kurrosetra/DisplayBangla/Documents/InternGerbong.jpeg

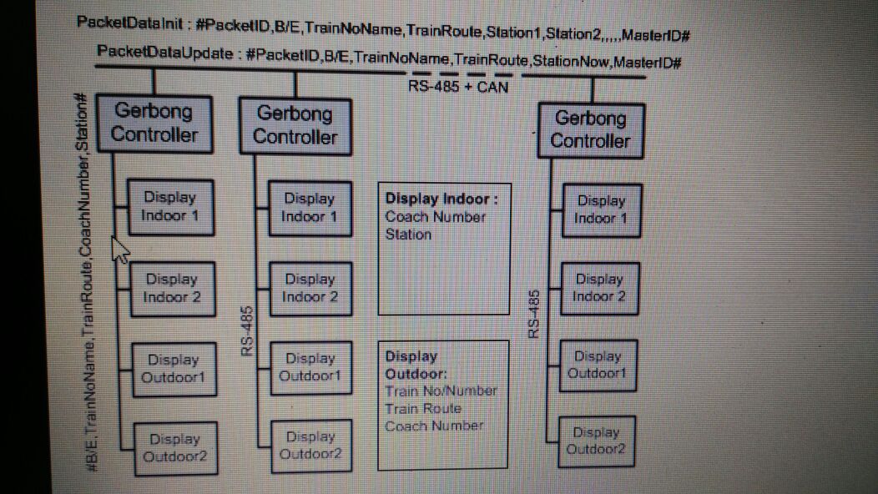
Documents/InternGerbong.jpeg
