kurrosetra/DisplayBangla/Documents/BlokGerbongController.jpeg

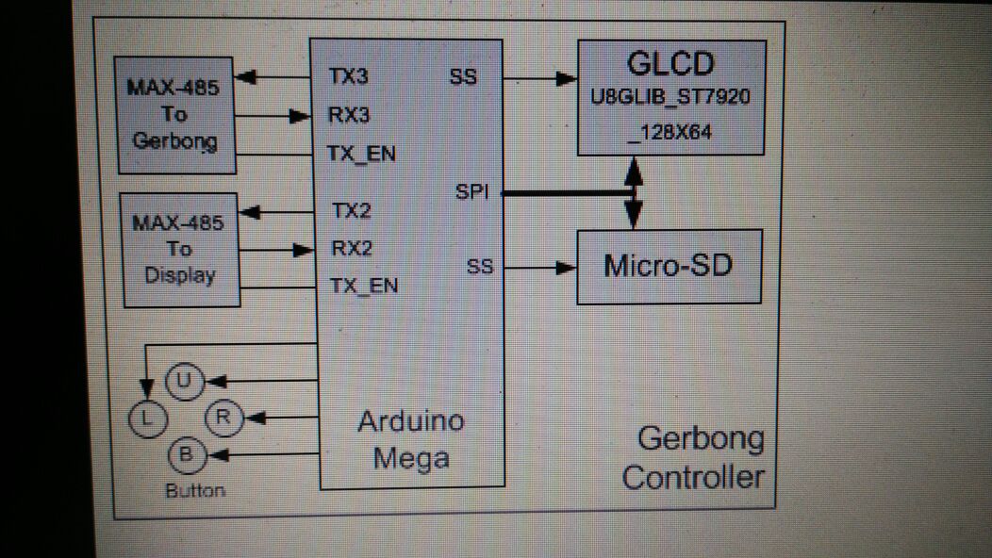
Documents/BlokGerbongController.jpeg
