kurrosetra/DisplayBangla/README.md

# DisplayBangla
INKA - Display for Bangladesh's train
