kurrosetra/DisplayBangla/Documents/Menu.jpeg

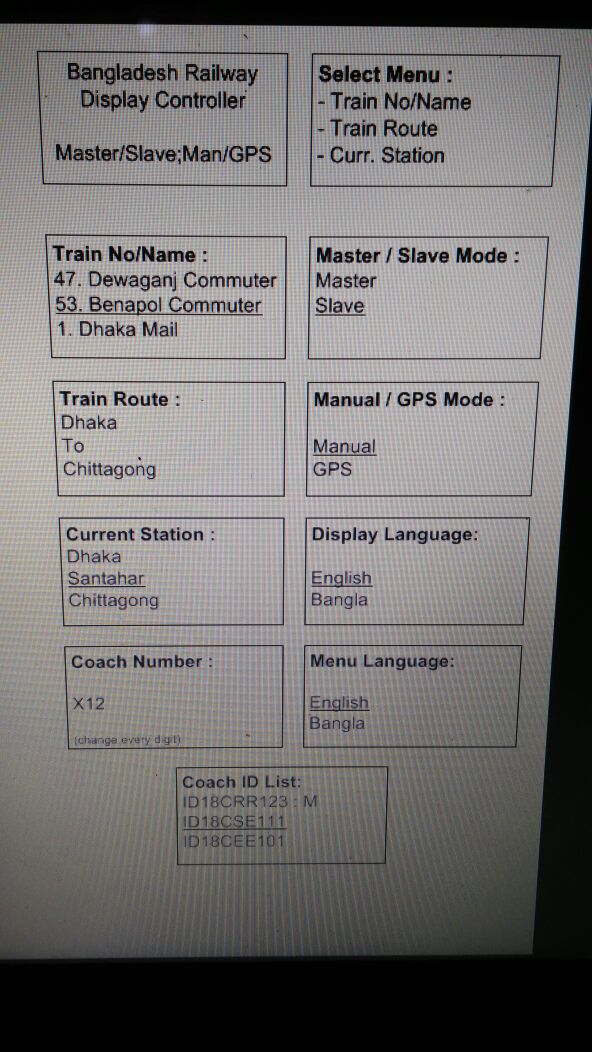
Documents/Menu.jpeg
