kurrosetra/DisplayBangla/Boards/rgbMatrix.brd

## EAGLE design Boards/rgbMatrix.brd (2018-09-11)

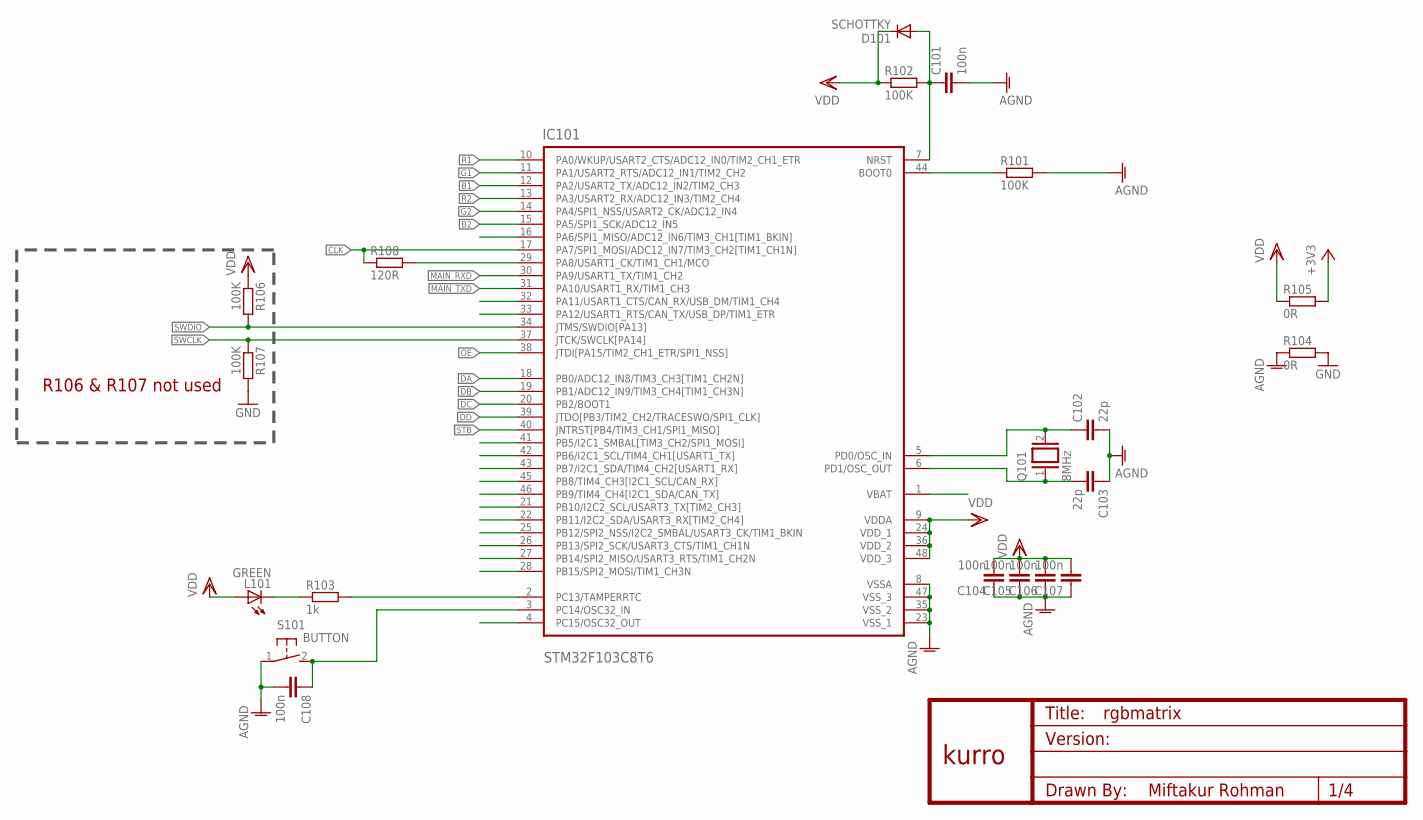
[picture p4: schematic rgbMatrix.sch, sheet 1, CONTROLLER]

Parts:
C101, C104, C105, C106, C107, C108: 100n; C0603
C102, C103: 22p; C0603
D101: SCHOTTKY; MICROMELF-W
IC101: STM32F103C8T6; QFP50P900X900X160-48N
L101: GREEN; LED3MM
Q101: 8MHz; QS
R101, R102, R106, R107: 100K; R0603
R103: 1k; R0603
R104, R105: 0R; R0603
R108: 120R; R0603
S101: BUTTON; B3F-01XXX
U$1: KURRO_FOOTPRINT; KURRO-LOGO

Connections:
+3V3: R105.2; also elsewhere on the board
AGND: C101.2, C102.2, C103.1, C104.1, C105.1, C106.1, C107.1, C108.2, IC101.8 (VSSA), IC101.23 (VSS_1), IC101.35 (VSS_2), IC101.47 (VSS_3), R101.2, R104.1, S101.1
B1: IC101.12 (PA2/USART2_TX/ADC12_IN2/TIM2_CH3); also elsewhere on the board
B2: IC101.15 (PA5/SPI1_SCK/ADC12_IN5); also elsewhere on the board
BOOT0: IC101.44 (BOOT0), R101.1
CLK: IC101.17 (PA7/SPI1_MOSI/ADC12_IN7/TIM3_CH2[TIM1_C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), R108.1; also elsewhere on the board
DA: IC101.18 (PB0/ADC12_IN8/TIM3_CH3[TIM1_CH2N]); also elsewhere on the board
DB: IC101.19 (PB1/ADC12_IN9/TIM3_CH4[TIM1_CH3N]); also elsewhere on the board
DC: IC101.20 (PB2/BOOT1); also elsewhere on the board
DD: IC101.39 (JTDO[PB3/TIM2_CH2/TRACESWO/SPI1_CLK]); also elsewhere on the board
G1: IC101.11 (PA1/USART2_RTS/ADC12_IN1/TIM2_CH2); also elsewhere on the board
G2: IC101.14 (PA4/SPI1_NSS/USART2_CK/ADC12_IN4); also elsewhere on the board
GND: R104.2, R107.2; also elsewhere on the board
LED1_BUILTIN: IC101.2 (PC13/TAMPERRTC), R103.2
MAIN_RXD: IC101.30 (PA9/USART1_TX/TIM1_CH2)
MAIN_TXD: IC101.31 (PA10/USART1_RX/TIM1_CH3); also elsewhere on the board
unnamed: IC101.29 (PA8/USART1_CK/TIM1_CH1/MCO), R108.2
unnamed: C103.2, IC101.6 (PD1/OSC_OUT), Q101.1
unnamed: C102.1, IC101.5 (PD0/OSC_IN), Q101.2
unnamed: L101.K (C), R103.1
unnamed: C108.1, IC101.3 (PC14/OSC32_IN), S101.2 (S)
OE: IC101.38 (JTDI[PA15/TIM2_CH1_ETR/SPI1_NSS]); also elsewhere on the board
R1: IC101.10 (PA0/WKUP/USART2_CTS/ADC12_IN0/TIM2_CH1_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); also elsewhere on the board
R2: IC101.13 (PA3/USART2_RX/ADC12_IN3/TIM2_CH4); also elsewhere on the board
RST: C101.1, D101.A, IC101.7 (NRST), R102.2
STB: IC101.40 (JNTRST[PB4/TIM3_CH1/SPI1_MISO]); also elsewhere on the board
SWCLK: IC101.37 (JTCK/SWCLK[PA14]), R107.1; also elsewhere on the board
SWDIO: IC101.34 (JTMS/SWDIO[PA13]), R106.2; also elsewhere on the board
VDD: C104.2, C105.2, C106.2, C107.2, D101.C, IC101.9 (VDDA), IC101.24 (VDD_1), IC101.36 (VDD_2), IC101.48 (VDD_3), L101.A, R102.1, R105.1, R106.1

Notes on the sheet:
R106 & R107 not used

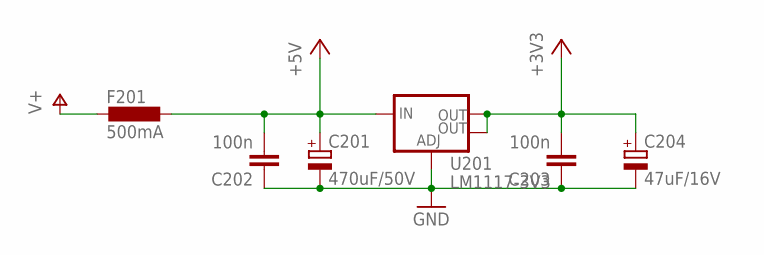
[picture p5: schematic rgbMatrix.sch, sheet 2, POWER]

Parts:
C201: 470uF/50V; E5-10,5
C202, C203: 100n; C0603
C204: 47uF/16V; E2-5
F201: 500mA; L1812
U201: LM1117-3V3; SOT223

Connections:
+3V3: C203.2, C204.+, U201.2 (OUT), U201.4 (OUT); also elsewhere on the board
+5V: C201.+, C202.2, F201.1, U201.3 (IN)
GND: C201.-, C202.1, C203.1, C204.-, U201.1 (ADJ); also elsewhere on the board
V+: F201.2; also elsewhere on the board

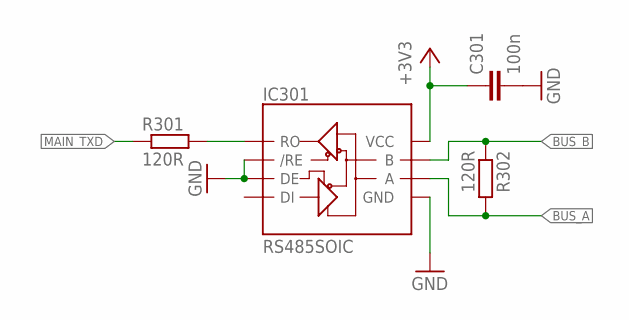
[picture p6: schematic rgbMatrix.sch, sheet 3, COMM]

Parts:
C301: 100n; C0603
IC301: RS485SOIC; SO08
R301, R302: 120R; R0603

Connections:
+3V3: C301.1, IC301.8 (VCC); also elsewhere on the board
BUS_A: IC301.6 (A), R302.2; also elsewhere on the board
BUS_B: IC301.7 (B), R302.1; also elsewhere on the board
GND: C301.2, IC301.2 (/RE), IC301.3 (DE), IC301.5 (GND); also elsewhere on the board
MAIN_TXD: R301.1; also elsewhere on the board
unnamed: IC301.1 (RO), R301.2

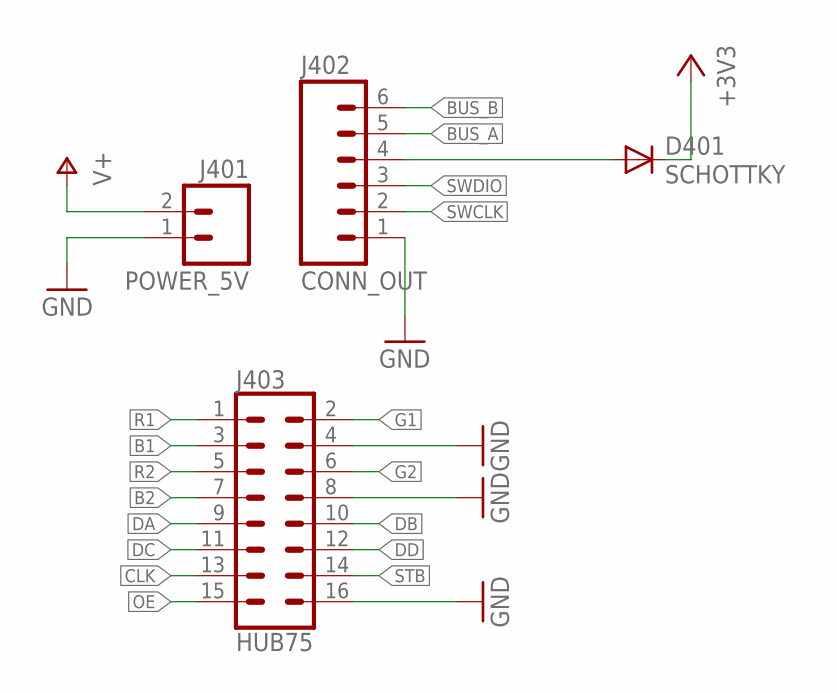
[picture p7: schematic rgbMatrix.sch, sheet 4, CONNECTOR]

Parts:
D401: SCHOTTKY; MICROMELF-W
J401: POWER_5V; XH-2-RA
J402: CONN_OUT; XH-6-RA
J403: HUB75; 2X08-LOCK

Connections:
+3V3: D401.C; also elsewhere on the board
B1: J403.3; also elsewhere on the board
B2: J403.7; also elsewhere on the board
BUS_A: J402.5; also elsewhere on the board
BUS_B: J402.6; also elsewhere on the board
CLK: J403.13; also elsewhere on the board
DA: J403.9; also elsewhere on the board
DB: J403.10; also elsewhere on the board
DC: J403.11; also elsewhere on the board
DD: J403.12; also elsewhere on the board
G1: J403.2; also elsewhere on the board
G2: J403.6; also elsewhere on the board
GND: J401.1, J402.1, J403.4, J403.8, J403.16; also elsewhere on the board
unnamed: D401.A, J402.4
OE: J403.15; also elsewhere on the board
R1: J403.1; also elsewhere on the board
R2: J403.5; also elsewhere on the board
STB: J403.14; also elsewhere on the board
SWCLK: J402.2; also elsewhere on the board
SWDIO: J402.3; also elsewhere on the board
V+: J401.2; also elsewhere on the board

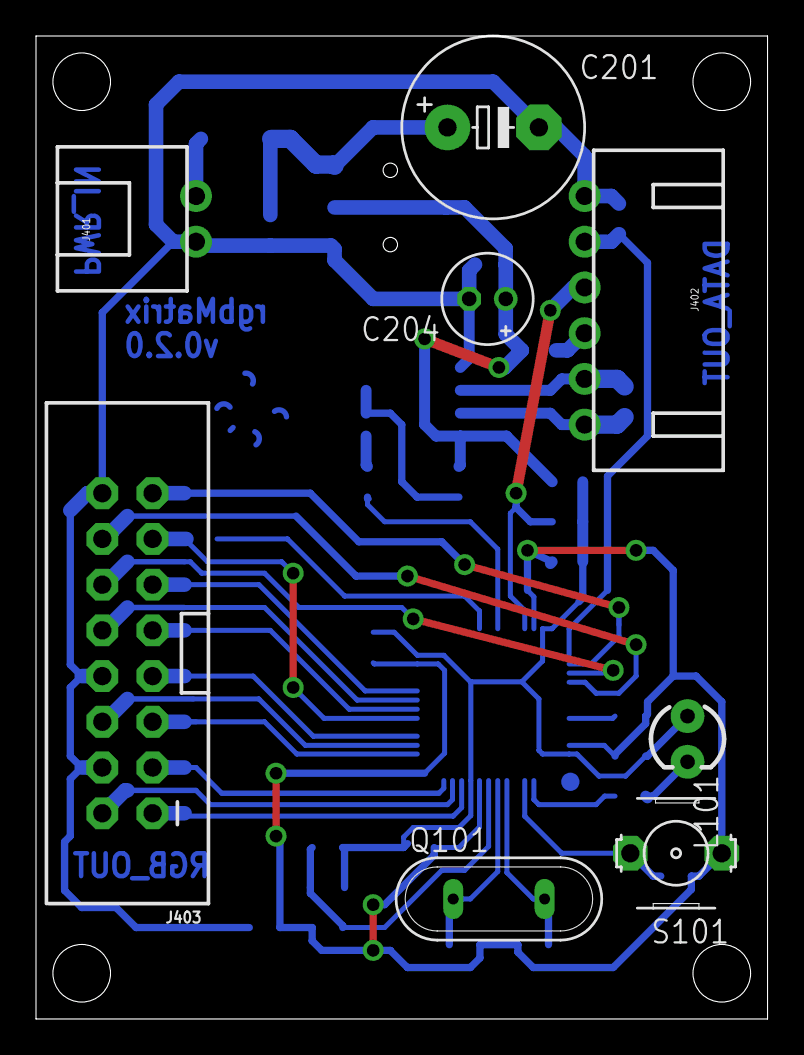
[picture p8: board rgbMatrix.brd from above]

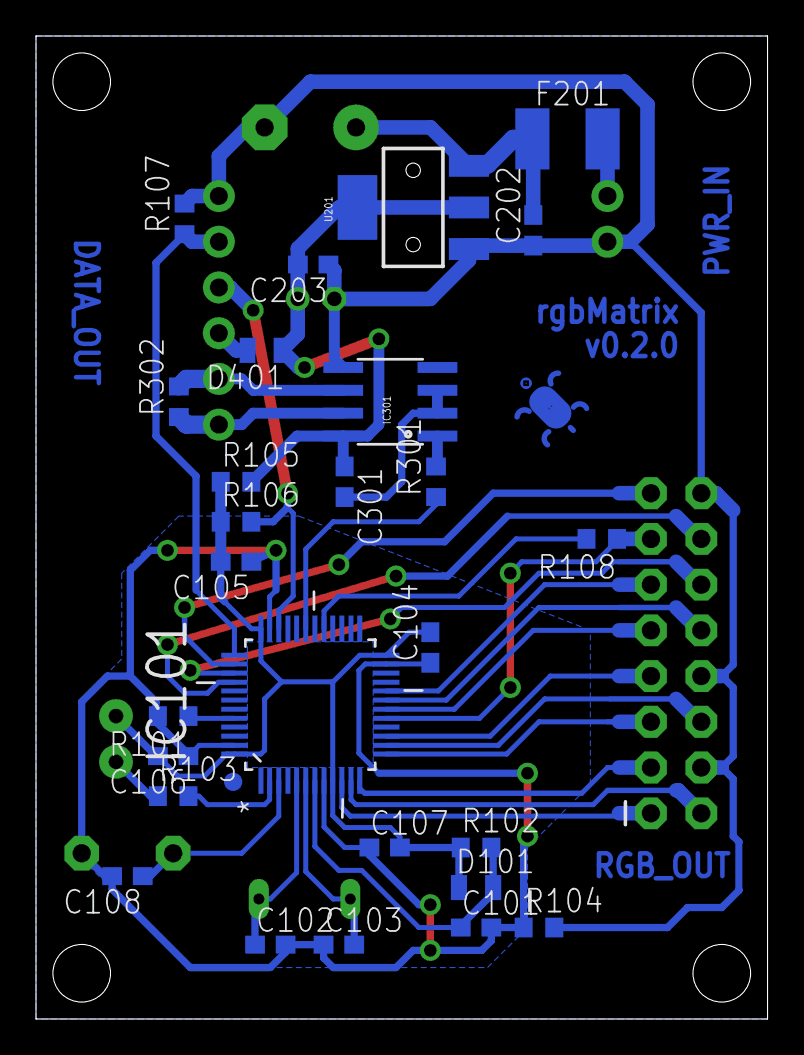
[picture p9: board rgbMatrix.brd from below]

Board: 2 copper layers, 40.6 x 54.6 mm, 36 parts (27 on the bottom side), 34 nets.
