kurrosetra/DisplayBangla/Boards/v2560.brd

## EAGLE design Boards/v2560.brd (2018-08-14)

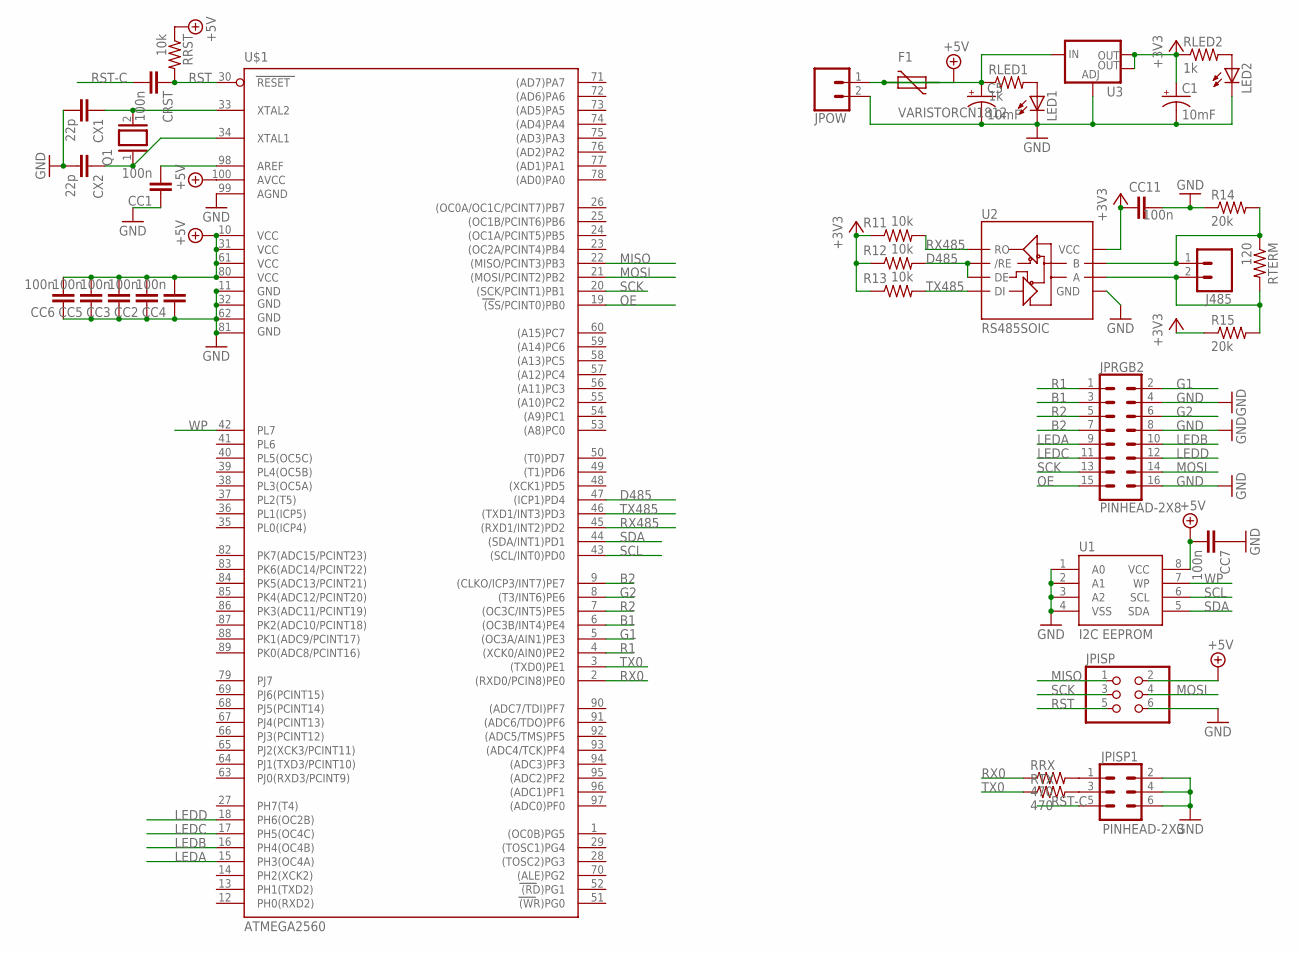
[picture p10: schematic v2560.sch]

Parts:
C1, C5: 10mF; CPOL-RADIAL-5MM-10MM
CC1, CC2, CC3, CC4, CC5, CC6, CC7, CC11: 100n; C0805
CRST: 100n; C0805
CX1, CX2: 22p; C0805
F1: VARISTORCN1812; CT/CN1812
J485: CONN_025MM; SCREWTERMINAL-5MM-2
JPISP: PINHD-2X3; 2X03
JPISP1: PINHEAD-2X3; 2X03-LOCK
JPOW: CONN_025MM; SCREWTERMINAL-5MM-2
JPRGB2: PINHEAD-2X8; 2X08-LOCK
LED1, LED2: LED3MM
Q1: XTAL/S; QS
R11, R12, R13: 10k; R0805
R14, R15: 20k; RES-0.3
RLED1, RLED2: 1k; R0805
RRST: 10k; R0805
RRX: 470; R0805
RTERM: 120; R0805
RTX: 470; R0805
U1: I2C EEPROM; SO08-EIAJ
U2: RS485SOIC; SO08
U3: V_REG_LM1117SOT223; SOT223
U$1: ATMEGA2560; TQFP100

Connections:
+3V3: C1.+, CC11.2, R11.1, R12.1, R13.1, R15.1, RLED2.1, U2.8 (VCC), U3.2 (OUT), U3.4 (OUT)
+5V: C5.+, CC2.2, CC3.2, CC4.2, CC5.2, CC6.2, CC7.2, F1.2, JPISP.2, RLED1.1, RRST.1, U1.8 (VCC), U3.3 (IN), U$1.10 (VCC), U$1.31 (VCC1), U$1.61 (VCC2), U$1.80 (VCC3), U$1.100 (AVCC)
AREF: CC1.2, U$1.98 (AREF)
B1: JPRGB2.3, U$1.6 ((OC3B/INT4)PE4)
B2: JPRGB2.7, U$1.9 ((CLKO/ICP3/INT7)PE7)
D485: R12.2, U2.2 (/RE), U2.3 (DE), U$1.47 ((ICP1)PD4)
G1: JPRGB2.2, U$1.5 ((OC3A/AIN1)PE3)
G2: JPRGB2.6, U$1.8 ((T3/INT6)PE6)
GND: C1.-, C5.-, CC1.1, CC2.1, CC3.1, CC4.1, CC5.1, CC6.1, CC7.1, CC11.1, CX1.2, CX2.2, JPISP.6, JPISP1.2, JPISP1.4, JPISP1.6, JPOW.2, JPRGB2.4, JPRGB2.8, JPRGB2.16, LED1.K (C), LED2.K (C), R14.1, U1.1 (A0), U1.2 (A1), U1.3 (A2), U1.4 (VSS), U2.5 (GND), U3.1 (ADJ), U$1.11 (GND), U$1.32 (GND1), U$1.62 (GND2), U$1.81 (GND3), U$1.99 (AGND)
LEDA: JPRGB2.9, U$1.15 (PH3(OC4A))
LEDB: JPRGB2.10, U$1.16 (PH4(OC4B))
LEDC: JPRGB2.11, U$1.17 (PH5(OC4C))
LEDD: JPRGB2.12, U$1.18 (PH6(OC2B))
MISO: JPISP.1, U$1.22 ((MISO/PCINT3)PB3)
MOSI: JPISP.4, JPRGB2.14, U$1.21 ((MOSI/PCINT2)PB2)
unnamed: J485.2, R15.2, RTERM.2, U2.6 (A)
unnamed: CX1.1, Q1.2, U$1.33 (XTAL2)
unnamed: CX2.1, Q1.1, U$1.34 (XTAL1)
unnamed: LED1.A, RLED1.2
unnamed: LED2.A, RLED2.2
unnamed: J485.1, R14.2, RTERM.1, U2.7 (B)
unnamed: F1.1, JPOW.1
unnamed: JPISP1.3, RTX.2
unnamed: JPISP1.1, RRX.2
OE: JPRGB2.15, U$1.19 ((SS/PCINT0)PB0)
R1: JPRGB2.1, U$1.4 ((XCK0/AIN0)PE2)
R2: JPRGB2.5, U$1.7 ((OC3C/INT5)PE5)
RST: CRST.1, JPISP.5, RRST.2, U$1.30 (RESET)
RST-C: CRST.2, JPISP1.5
RX0: RRX.1, U$1.2 ((RXD0/PCIN8)PE0)
RX485: R11.2, U2.1 (RO), U$1.45 ((RXD1/INT2)PD2)
SCK: JPISP.3, JPRGB2.13, U$1.20 ((SCK/PCINT1)PB1)
SCL: U1.6 (SCL), U$1.43 ((SCL/INT0)PD0)
SDA: U1.5 (SDA), U$1.44 ((SDA/INT1)PD1)
TX0: RTX.1, U$1.3 ((TXD0)PE1)
TX485: R13.2, U2.4 (DI), U$1.46 ((TXD1/INT3)PD3)
WP: U1.7 (WP), U$1.42 (PL7)

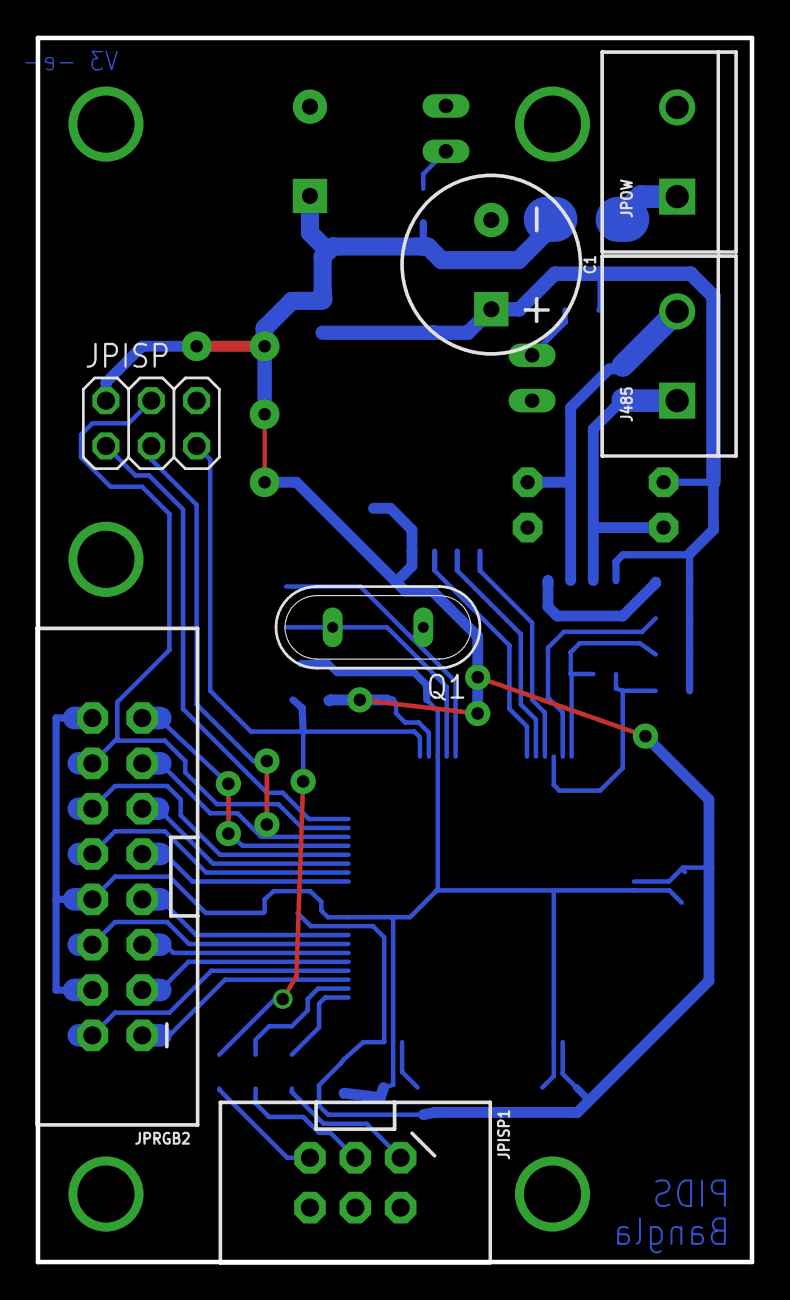
[picture p11: board v2560.brd from above]

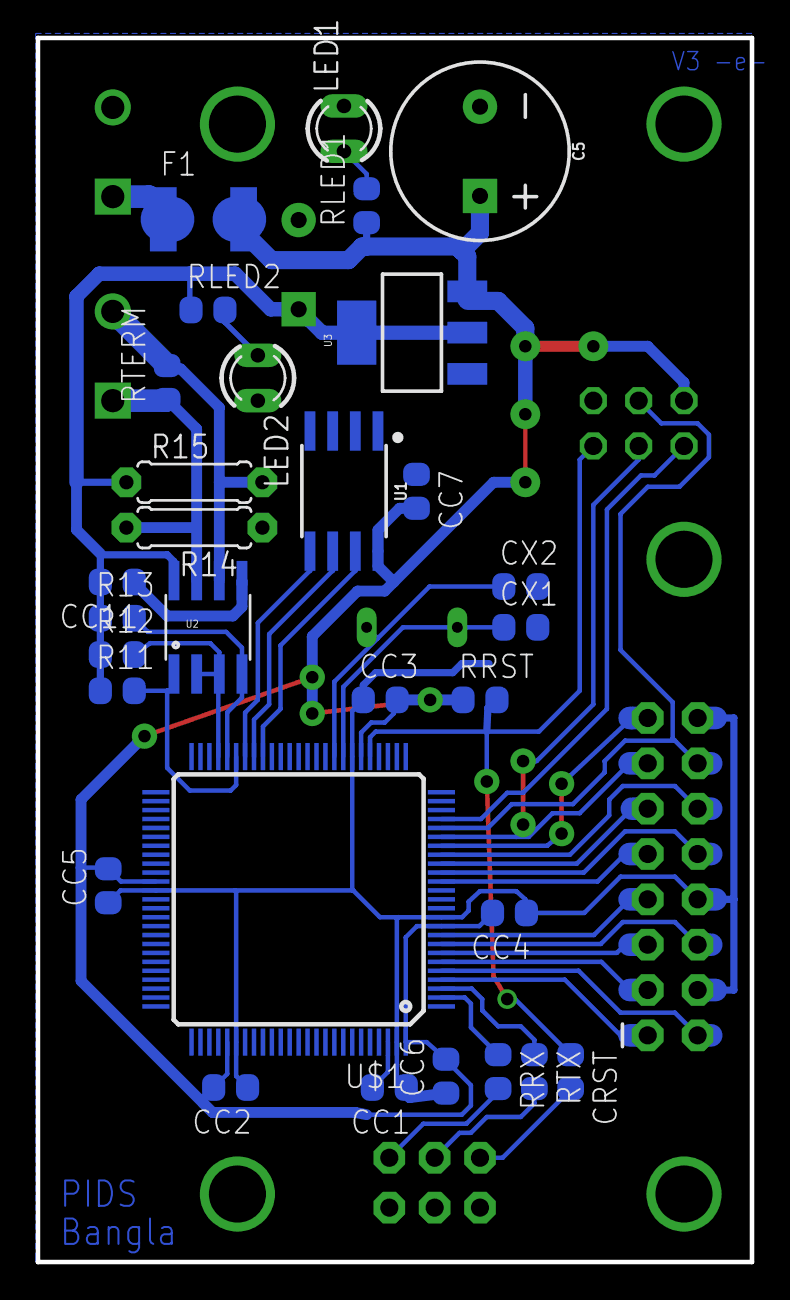
[picture p12: board v2560.brd from below]

Board: 2 copper layers, 40.0 x 68.6 mm, 37 parts (30 on the bottom side), 37 nets.
