kurrosetra/DisplayBangla/Boards/kontroller2.brd

## EAGLE design Boards/kontroller2.brd (2018-07-13)

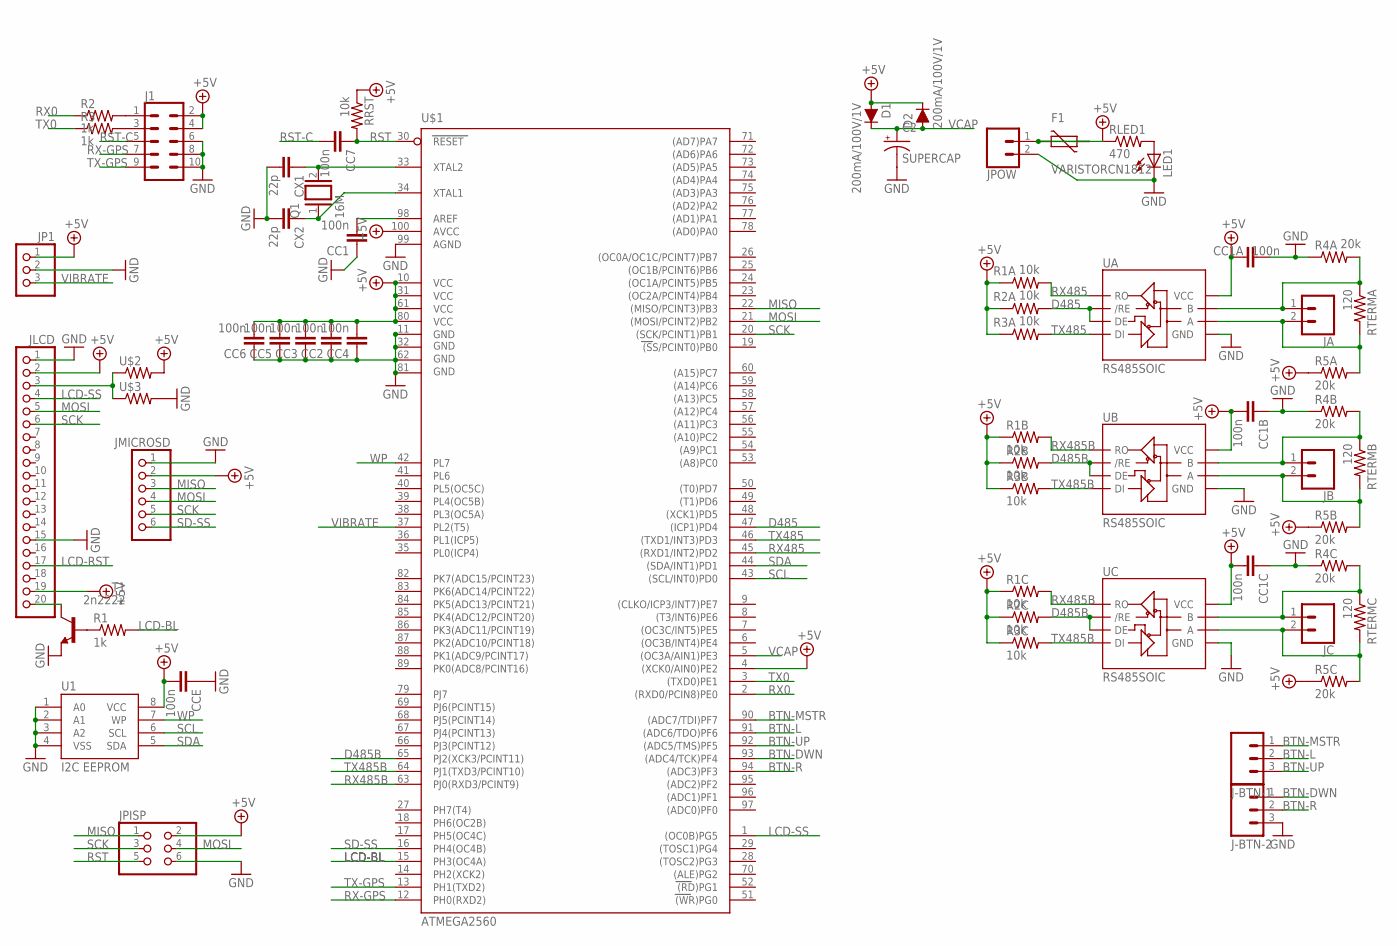
[picture p13: schematic kontroller2.sch]

Parts:
C2: SUPERCAP; SUPERCAP-25MM
CC1, CC1A, CC1B, CC1C, CC2, CC3, CC4, CC5, CC6, CC7: 100n; C0805
CCE: 100n; C0805
CX1, CX2: 22p; C0805
D1, D2: 200mA/100V/1V; DIODE-1N4148
F1: VARISTORCN1812; CT/CN1812
J1: CONN_05X2SHD_LOCK; 2X5-SHROUDED_LOCK
J-BTN-1, J-BTN-2: M03-SCREW-5MM; SCREWTERMINAL-5MM-3
JA: CONN_025MM; SCREWTERMINAL-5MM-2
JB: CONN_025MM; SCREWTERMINAL-5MM-2
JC: CONN_025MM; SCREWTERMINAL-5MM-2
JLCD: PINHD-1X20; 1X20
JMICROSD: PINHD-1X6; 1X06
JP1: PINHD-1X3; 1X03
JPISP: PINHD-2X3; 2X03
JPOW: CONN_025MM; SCREWTERMINAL-5MM-2
LED1: LED3MM
Q1: 16M; QS
R1, R2, R3: 1k; R0805
R1A, R1B, R1C, R2A, R2B, R2C, R3A, R3B, R3C: 10k; R0805
R4A, R4B, R4C, R5A, R5B, R5C: 20k; RES-0.3
RLED1: 470; R0805
RRST: 10k; R0805
RTERMA: 120; R0805
RTERMB: 120; R0805
RTERMC: 120; R0805
T1: 2n2222; TO92-EBC
U1: I2C EEPROM; SO08-EIAJ
U$1: ATMEGA2560; TQFP100
U$2, U$3: RES_R0805; R0805
UA: RS485SOIC; SO08
UB: RS485SOIC; SO08
UC: RS485SOIC; SO08

Connections:
+5V: CC1A.2, CC1B.2, CC1C.2, CC2.2, CC3.2, CC4.2, CC5.2, CC6.2, CCE.2, D1.A, D2.C, F1.2, J1.2, J1.4, JLCD.2, JLCD.19, JMICROSD.2, JP1.1, JPISP.2, R1A.1, R1B.1, R1C.1, R2A.1, R2B.1, R2C.1, R3A.1, R3B.1, R3C.1, R5A.1, R5B.1, R5C.1, RLED1.1, RRST.1, U1.8 (VCC), U$1.4 ((XCK0/AIN0)PE2), U$1.10 (VCC), U$1.31 (VCC1), U$1.61 (VCC2), U$1.80 (VCC3), U$1.100 (AVCC), U$2.2, UA.8 (VCC), UB.8 (VCC), UC.8 (VCC)
AREF: CC1.2, U$1.98 (AREF)
BTN-DWN: J-BTN-2.1, U$1.93 ((ADC4/TCK)PF4)
BTN-L: J-BTN-1.2, U$1.91 ((ADC6/TDO)PF6)
BTN-MSTR: J-BTN-1.1, U$1.90 ((ADC7/TDI)PF7)
BTN-R: J-BTN-2.2, U$1.94 ((ADC3)PF3)
BTN-UP: J-BTN-1.3, U$1.92 ((ADC5/TMS)PF5)
D485: R2A.2, U$1.47 ((ICP1)PD4), UA.2 (/RE), UA.3 (DE)
D485B: R2B.2, R2C.2, U$1.65 (PJ2(XCK3/PCINT11)), UB.2 (/RE), UB.3 (DE), UC.2 (/RE), UC.3 (DE)
GND: C2.-, CC1.1, CC1A.1, CC1B.1, CC1C.1, CC2.1, CC3.1, CC4.1, CC5.1, CC6.1, CCE.1, CX1.2, CX2.2, J1.6, J1.8, J1.10, J-BTN-2.3, JLCD.1, JLCD.15, JMICROSD.1, JP1.2, JPISP.6, JPOW.2, LED1.K (C), R4A.1, R4B.1, R4C.1, T1.E, U1.1 (A0), U1.2 (A1), U1.3 (A2), U1.4 (VSS), U$1.11 (GND), U$1.32 (GND1), U$1.62 (GND2), U$1.81 (GND3), U$1.99 (AGND), U$3.2, UA.5 (GND), UB.5 (GND), UC.5 (GND)
LCD-BL: R1.2, U$1.15 (PH3(OC4A))
LCD-RST: JLCD.17
LCD-SS: JLCD.4, U$1.1 ((OC0B)PG5)
MISO: JMICROSD.3, JPISP.1, U$1.22 ((MISO/PCINT3)PB3)
MOSI: JLCD.5, JMICROSD.4, JPISP.4, U$1.21 ((MOSI/PCINT2)PB2)
unnamed: JA.2, R5A.2, RTERMA.2, UA.6 (A)
unnamed: JC.1, R4C.2, RTERMC.1, UC.7 (B)
unnamed: JB.1, R4B.2, RTERMB.1, UB.7 (B)
unnamed: JB.2, R5B.2, RTERMB.2, UB.6 (A)
unnamed: CX1.1, Q1.2, U$1.33 (XTAL2)
unnamed: CX2.1, Q1.1, U$1.34 (XTAL1)
unnamed: LED1.A, RLED1.2
unnamed: JLCD.3, U$2.1, U$3.1
unnamed: JLCD.20, T1.C
unnamed: R1.1, T1.B
unnamed: J1.1, R2.2
unnamed: J1.3, R3.2
unnamed: F1.1, JPOW.1
unnamed: JC.2, R5C.2, RTERMC.2, UC.6 (A)
unnamed: JA.1, R4A.2, RTERMA.1, UA.7 (B)
RST: CC7.1, JPISP.5, RRST.2, U$1.30 (RESET)
RST-C: CC7.2, J1.5
RX0: R2.1, U$1.2 ((RXD0/PCIN8)PE0)
RX485: R1A.2, U$1.45 ((RXD1/INT2)PD2), UA.1 (RO)
RX485B: R1B.2, R1C.2, U$1.63 (PJ0(RXD3/PCINT9)), UB.1 (RO), UC.1 (RO)
RX-GPS: J1.7, U$1.12 (PH0(RXD2))
SCK: JLCD.6, JMICROSD.5, JPISP.3, U$1.20 ((SCK/PCINT1)PB1)
SCL: U1.6 (SCL), U$1.43 ((SCL/INT0)PD0)
SD-SS: JMICROSD.6, U$1.16 (PH4(OC4B))
SDA: U1.5 (SDA), U$1.44 ((SDA/INT1)PD1)
TX0: R3.1, U$1.3 ((TXD0)PE1)
TX485: R3A.2, U$1.46 ((TXD1/INT3)PD3), UA.4 (DI)
TX485B: R3B.2, R3C.2, U$1.64 (PJ1(TXD3/PCINT10)), UB.4 (DI), UC.4 (DI)
TX-GPS: J1.9, U$1.13 (PH1(TXD2))
VCAP: C2.+, D1.C, D2.A, U$1.5 ((OC3A/AIN1)PE3)
VIBRATE: JP1.3, U$1.37 (PL2(T5))
WP: U1.7 (WP), U$1.42 (PL7)

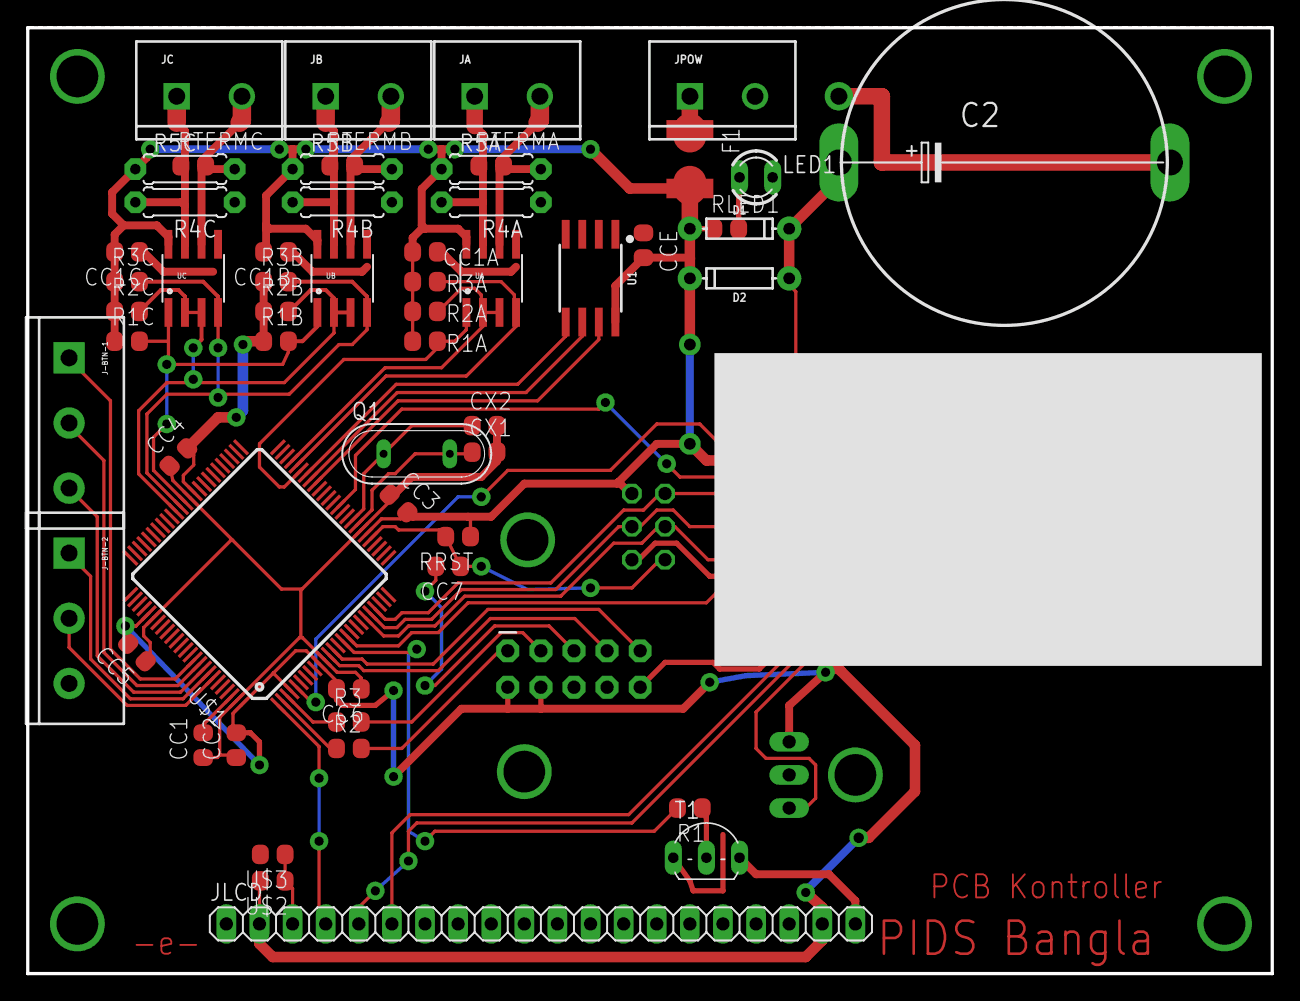
[picture p14: board kontroller2.brd from above]

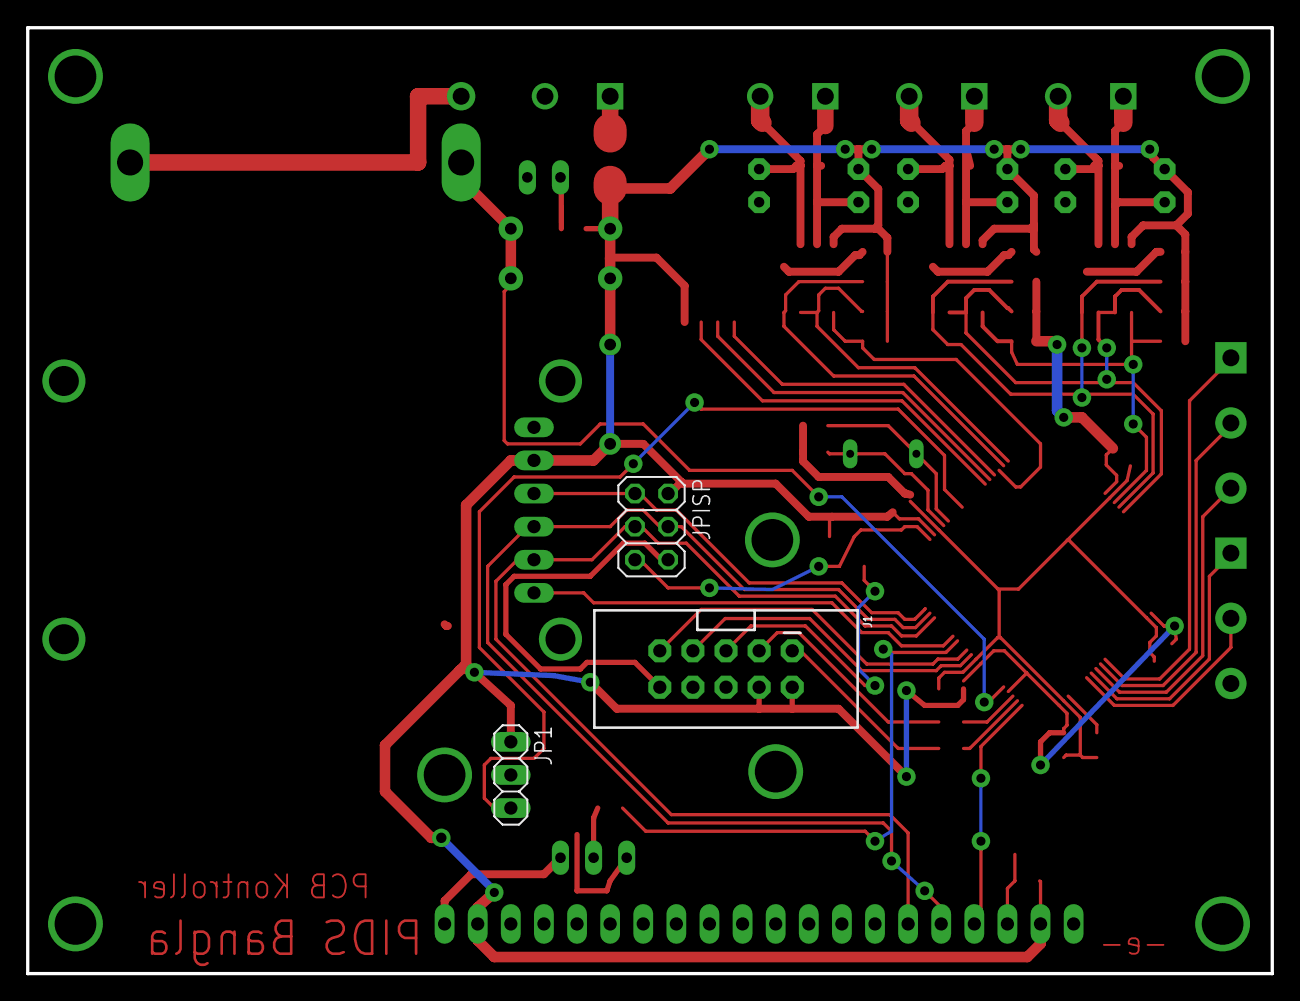
[picture p15: board kontroller2.brd from below]

Board: 2 copper layers, 95.5 x 72.6 mm, 61 parts (3 on the bottom side), 46 nets.
