kurrosetra/DisplayBangla/(commit log)

2018-03-22 update
    - add example pid files
    - downgrade u8g2 library to u8g
    - add main page
    - add menu page (incomplete)
2018-03-23 delete menuDisplay class
    due to simplicity of transfer data button, lcd & sd card
2018-03-26 update current station submenu page
2018-03-27 update
    - delete "DEFAULT.txt" as temporary train info holder, train info will be search straight within SD
    - create trainDetal.h that contain Train_Detail struct due to eclipse sloeber limitation when using function with struct as parameter
    - change sdUpdateTrainDetail() function to sdUpdateTrainDetail(Train_Detail *td)
    - change station menu according to trainRoute option
    - each time trainRoute option's changed, currentStationPosition & currentStationName will be updated as well
2018-04-02 fix storageBank
    previous:
    each full cycles, block header update 5x
    update:
    each full cycles, block header update 1x
    [storageBankAddress.xlsx]
2018-04-17 hotfix
    fix:
    if coach.txt in the middle/ not in first line
    [mainTrain.ino, storageBank.cpp, storageBank.h, store_and_load_example.ino]
2018-04-17 Revert "Implement comm function"
    This reverts commit 3894bb4b592562701d81fb088c44ee22dd204580.
    [mainTrain.ino]
2018-04-17 Revert "hotfix"
    This reverts commit 09f8be90277431a554eb64818dcf1b734301ec4b.
    [mainTrain.ino, storageBank.cpp, storageBank.h, store_and_load_example.ino]
2018-07-23 beta release
    [v2560.brd, v2560.sch]
2018-07-23 Revert "adding library u8g for lcd"
    This reverts commit eb5ddd7eb6f6b827ffd762f3ad1e75b023514e03.
    [mainTrain.ino, test_mainTrain.ino]
2018-08-14 1.1.0
    add bangla font
    [v2560.brd]
2018-08-19 1.2.0b
    add coordinate to pid file
    [List Stasiun Bangla.xlsx]
2018-09-07 1.2.1
    hotfix:
    1. busparsing fixed
    2. start masterUpdateTrainBangla() when buttonUpdate
    [mainTrain.ino]
2018-09-11 v1.3.0
    MAJOR UPDATE:
    add Display module with stm32f103c8t6
    todo list:
    1. parsing command
    2. layout
    [rgbMatrix.brd, rgbMatrix.sch]
2018-09-14 v1.3.1
    MINOR UPDATE:
    add parsing functions
    1. layout
    2. add swapbuffer
    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
    [main.c, main.h]
2018-09-14 v1.3.2
    add swapbuffer
    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
    [main.c]
2018-09-14 v1.3.3
    layout:
    1. english & bangla
    todo:
    1. bintik2, ganti ke dma mem_to_mem?
    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
2018-09-17 v1.3.4
    HOTFIX UPDATE:
    1. dma from timer compare to timer update
    1. layout animation
    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
2018-09-18 v1.3.6
    FIX UPDATE:
    1. layout Outdoor & Indoor
    2. create HEX binaries files
    [main.c, main.h]
2018-09-19 v1.3.6b
    1. all red color
    2. slower running speed
    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
    [main.c]
2018-09-20 v1.3.6c
    1. fix serial data sequence (coachName)
    2. indoor: fix trainRoute in bangla (eliminate unwanted space)
    3. outdoor: fix trainRoute in english&bangla (running animation bug)
    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
    [main.c]
2018-09-24 v1.3.6c2
    1. Outdoor bangla layoutTrainName constrain from "xTrainIdLineEnd" change to "xCoachLineEnd"
    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
    [main.c]
2018-09-24 v1.3.7
    1. GPS function tested
    2. coachName space char fixed
    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
    [mainTrain.ino]
2018-10-05 v1.3.8
    1. kontroller:
    a. update hardware
    b. change pinout in software
    2. display:
    a. add ring buffer to capture serial command (no glitch anymore
    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
    [F103_rgbMatrix.ioc, main.c, main.h, mainTrain.ino]
2018-10-09 v1.3.8a
    1. Display Module:
    a. set brightness level of INDOOR display from 20% to 50%
    2. Kontroller Module:
    a. available for v3 & v3a
    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
    [main.c, mainTrain.ino]
2018-10-09 v1.3.8b
    a. lengthening DISPLAY_REFRESH_TIMEOUT from 10s to 30s to accomodate longer string to be displayed.
    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
    [main.c]
2018-10-10 v.1.3.8c
    FIX Update:
    1. support controller v3 & v3a (previously different pinout in schematic of controller v3)
    [mainTrain.ino]
2019-09-05 v1.5.0
    Changelog v1.5.0:
    - [MAJOR] support outdoor module with new IC led driver (ICN2308S) that need 3 clock when LATCH HIGH
    - [MAJOR] change timing control for display module
    v1.3.9, v1.4.0 & 1.4.1 from edes:
    change in v.1.4.1:
    - corrected display of Coach-ID if 4-digit is assigned
    changelog V.1.4.0 :
    1. update OE_ARR dari 14399 ke 28799 di main.h
    2. update OE_min*650/1000 di main.C
    3. change Railways to Railway, and re-positioning to middle
    4. adding char "KS" and "PR" of bangla in "express" sentence
    Changelog v1.3.9:
    (not available)
    [F103_rgbMatrix_testing.ioc, main.c, main.h]
