kurrosetra/DisplayBangla/(notices)

Notices in the files:
Firmwares/F103_rgbMatrix/F103_rgbMatrix/Src/main.c:
(C) COPYRIGHT STMicroelectronics *****END OF FILE
parts and their libraries:
SparkFun-Connectors: Licensing: CC v3.0 Share-Alike You are welcome to use this library for commercial purposes.
SparkFun-DigitalIC: Licensing: Creative Commons ShareAlike 4.0 International - https://creativecommons.org/licenses/by-sa/4.0
